ElectroIGO/bak_rl/docs/title_page.tex

\begin{titlepage}
\begin{center}
\textbf{
VENTSPILS AUGSTSKOLA\\
INFORMĀCIJAS TEHNOLOĢIJU FAKULTĀTE}\\
\vspace{1.2cm}
\textbf{BAKALAURA DARBS}\\
\vspace{1.4cm}
{\LARGE \textbf{X joslas raidīšanas sistēmas vadības bloka prototipa izstrāde}}\\
\vspace{1cm}
\begin{tabular}{@{}r@{}l@{}}
\parbox[c]{0.4\textwidth}{Autors:}&
\parbox[t]{0.6\textwidth}{
Ventspils Augstskola\\
Informācijas tehnoloģiju fakultātes\\
profesionālās bakalaura studiju programmas \\ "Elektronikas inženierija"\\
4. kursa students\\
Rodrigo Laurinovičs \\
Matrikulas~Nr. 190050 \vspace{0.7em}\\
\mbox{}\hrulefill\vspace{-0.4em}\\
{\scriptsize(paraksts)}\vspace{1.2cm}} \\
\parbox[c]{0.4\textwidth}{Fakultātes dekāns:}&
\parbox[t]{0.6\textwidth}{
doc. Dr. Sc.Comp. Vairis Caune \vspace{.7em}\\
\mbox{}\hrulefill\vspace{-0.4em}\\
{\scriptsize(paraksts)}\vspace{1.2cm}} \\
%-------------------------------------------------------------------------
\parbox[c]{0.4\textwidth}{Zinātniskais vadītājs:}&
\parbox[t]{0.6\textwidth}{
Mg. Sc. Ing. Mārcis Bleiders \vspace{.7em}\\
\mbox{}\hrulefill\vspace{-0.4em}\\
{\scriptsize(paraksts)}\vspace{1.2cm}} \\
%----------------------------------------------------------------------------------
\parbox[c]{0.4\textwidth}{Recenzents:} & %\vspace{.7em}\\
\parbox[t]{0.6\textwidth}{
Mg. Sc. Ing. Artūrs Orbidāns  \vspace{.7em}\\
%\mbox{}\hrulefill\vspace{-0.4em}\\

%{\scriptsize(Ieņemamais amats, zinātniskais nosaukums,
%vārds, uzvārds)}\vspace{2em}

\mbox{}\hrulefill\vspace{-0.4em}\\
{\scriptsize(paraksts)}\vspace{1.2em}} \\
\end{tabular}
\vfill
Ventspils, 2025
\end{center}
\end{titlepage}
