ElectroIGO/bak_rl/docs/sections/theory/power_amplifier.tex

\section{Augstas jaudas RF pastiprinātājs}
Radiofrekvences \cite{poweramplifieroverview} (RF) tīkla signālu ķēdē jaudas pastiprinātāji ieņem vietu kā pēdējais elements, sekojot tādām komponentēm kā maztrokšņojoši pastiprinātāji (LNA), jaucējiem un citām signālu apstrādes pakāpēm. Jaudas pastiprinātāji ir atbildīgi par būtisku uzdevumu – pastiprināt signālu līdz nepieciešamajam jaudas līmenim tā raidīšanai. Signāls tiek pastiprināts, lai spētu pārraidīt signālu lielos attālumos.

RF jaudas pastiprinātāji ir sastopami gandrīz visās bezvadu ierīcēs – sākot no bezvadu komunikācijas sistēmām, satelītkomunikācijām, raidīšanas iekārtām, mobilajiem tālruņiem līdz IoT ierīcēm.
