ElectroIGO/bak_rl/docs/main.tex

\documentclass[12pt,paper=a4]{report}
\usepackage[utf8]{inputenc}
\usepackage{polyglossia}
%Atkāpes pirmajām rindiņām
\usepackage{indentfirst}
%Virsrakstu noformējumam
\usepackage{titlesec}
%Attēlu importēšanai
\usepackage{graphicx}
%Vajadzēs saliktus attēlus
\usepackage{subcaption}
\usepackage{float}
%Nodefinē attālumus no malām
\usepackage[a4paper, lmargin=3.5cm,rmargin=2cm,tmargin=2cm, bmargin=2cm]{geometry}
%rotēšana
\usepackage{rotating, graphicx}
%Apjomīgām tabulām
\usepackage{longtable}
% tabulu šūnu satura centrēšanai
\usepackage{array}
\newcolumntype{P}[1]{>{\centering\arraybackslash}p{#1}}
\newcolumntype{M}[1]{>{\centering\arraybackslash}m{#1}}
%Numerācijai lappuses labajā pusē
\usepackage{fancyhdr}
%Literatūras saraksta veidošanai
%\usepackage{natbib}
\usepackage{hyperref} % For clickable links
\usepackage{url}      % For better URL formatting
\bibliographystyle{IEEEtran}

%Garas formulas
\usepackage{amsmath}

%tabulas
\usepackage{booktabs}
\usepackage{adjustbox}

% rindu sapludināšana tabulā
\usepackage{multirow}% http://ctan.org/pkg/multirow
\usepackage{hhline}% http://ctan.org/pkg/hhline
%laas tabulas
\usepackage{tabularx}
\usepackage{boldline}
%Lai varetu ievietot lapu landscape
\usepackage{lscape}
% pielikumam
\usepackage[titletoc]{appendix}
% Allows line breaks within cells
\usepackage{array}     % For column alignment
\usepackage{makecell}  % For line breaks in headers

\usepackage{pgfplots} % Required for plotting
\pgfplotsset{compat=1.18} % Ensure compatibility
\usepackage{siunitx} % For SI unit formatting

\usepackage{svg}
%Noformējuma parametri---------------------------------------------------------------------------------------------
%Nodefinējam valodas
\usepackage[labelsep=space]{caption} % Global setting for all tables
\setdefaultlanguage{latvian}
\setotherlanguages{english,russian}

%Fonts un atstarpe starp rindām
\setmainfont{Times New Roman}
%Rindiņas pirmā atkāpe
\setlength{\parindent}{1.27cm}
\usepackage{setspace}
\onehalfspacing
%Apakšmape bildēm
\graphicspath{{./pictures/}{./Schematics/}}

\renewcommand{\sfdefault}{ptm}

\titleformat{\chapter}
  {\centering\sffamily\fontsize{16}{16}\bfseries}{\thechapter \space{}}{0pc}{}
\titleformat{\section}{\sffamily\fontsize{14}{14}\bfseries}{\thesection \space{}}{0pc}{}
\titleformat{\subsection}{\sffamily\fontsize{12}{12}\bfseries}{\thesubsection \space{}}{0pc}{}
\titlespacing*{\chapter}{0pt}{0pt}{15pt} 
\titlespacing*{\section}{0pt}{20pt}{10pt} 
\titlespacing*{\subsection}{0pt}{15pt}{10pt} 

%Nodefinējam objektu numerācijas noteikumus
\def\thechapter      {\arabic{chapter}}
\def\thesection      {\ifx\chapter.\undefined{\arabic{section}}\else  {\thechapter.\arabic{section}}\fi}
\def\thesubsection   {\thesection.\arabic{subsection}}
\def\thesubsubsection{\thesubsection.\arabic{subsubsection}}

\usepackage{pdfpages}

\renewcommand{\thefigure}{\arabic{chapter}.\arabic{figure}.}
\renewcommand{\theequation}{\thechapter.\arabic{equation}.}
\renewcommand{\thetable}{\thechapter.\arabic{table}.}
%Attelu un tabulu nosaukumi
%\captionsetup[figure] {labelformat=default,labelsep=space,justification=centerlast}
%\captionsetup[table] {labelformat=simple,labelsep=newline,textfont=bf}
%\renewcommand{\figurename}{att.}

%\renewcommand{\tablename}{tabula}
%\renewcommand{\appendixname}{Pielikums}
%\makeatletter
%\renewcommand{\fnum@figure}{}
%\makeatother
%Teksta nodaļu fiksētie nosaukumi
\addto\captionslatvian{
\renewcommand\bibname{Izmantotās literatūras un avotu saraksts}
\renewcommand{\contentsname}{Saturs}
}

%Numeracija

\pagestyle{fancy}

\fancyhf{}
\renewcommand{\headrulewidth}{0pt} 
\renewcommand{\footrulewidth}{0pt}
\fancyfoot[R]{\thepage}
\fancypagestyle{plain}{%
  \fancyfoot[R]{\thepage}%
}
%Pārnesumiem - ļauj tiasīt lielākas starpas
\hyphenpenalty=5000
%% Atraitņrindiņas un bāreņrindiņas ( widow orphan) vadība
\clubpenalty10000
\widowpenalty10000
% Apakšsvītrām
\usepackage{underscore}
% pārkares paragrāfiem (speciāli saīsinājumiem)
\newenvironment{hangingpar}[1]
  {\begin{list}
          {}
          {\setlength{\itemindent}{-#1}%%'
           \setlength{\leftmargin}{#1}%%'
           \setlength{\itemsep}{0pt}%%'
           \setlength{\parsep}{\parskip}%%'
           \setlength{\topsep}{\parskip}%%'
           }
    \setlength{\parindent}{-#1}%%
    \item[]
  }
  {\end{list}}

%\renewcommand{\baselinestretch}{1.5}
\fontsize{12pt}{1.2}
\linespread{1.25} %1.2 *1.25 = 1.5

\begin{document}

% % Titullapa
\input{title_page.tex}
\pagenumbering{gobble}
%Vieta anotācijām---------------------------------------------------------------------------
\input{LV_abstract.tex}
\input{ENG_abstract.tex}
%Saturs---------------------------------------------------------------------------------------
\tableofcontents
\input{abbreviations.tex}
\clearpage
\pagenumbering{arabic}
\setcounter{page}{6}
\input{sections/ievads.tex}
\input{sections/teorija.tex}
\input{sections/izstrade.tex}
\input{sections/testesana.tex}
\input{sections/secinajumi.tex}
\bibliography{refs}
%\input{pielikumi.tex}
\includepdf[pages=-]{Galvojums.pdf}

\end{document}
