ElectroIGO/bak_rl/docs/sections/izstrade.tex

\chapter{X joslas raidīšanas sistēmas vadības bloka prototipa izstrāde}

Šajā nodaļā ir izklāstīta šī bakalaura darba ietvaros veiktā X joslas raidīšanas sistēmas vadības bloka prototipa izstrāde. Sākas nodaļa ar sistēmas pārskatu, tad tiek aprakstīts darba punkta iestatīšanas izstrādes process, kur tiek aprakstītas izveidotās iespiedplates, pēc kā tiek pievērsta uzmanība mikrokontrolierim, programmas kodam un lietojumprogrammas izstrādei, tad tiek aprakstīta jaudas monitorēšanas sistēmas izstrāde, kur beigās ir gala prototipu apraksts, kur tiek aprakstīts atsevišķo sistēmu novietojums korpusā. Visas izstrādnes, kas tika izstrādātas šī bakalaura ietvaros, tiek uzglabātas githubā\cite{bak_github}.

\input{sections/development/system_overview}
\input{sections/development/bias_system}
\input{sections/development/mcu_code}
\input{sections/development/power_system}
\input{sections/development/finished_prototype}
