ElectroIGO/bak_rl/docs/sections/teorija.tex

\chapter{Teorija}
Šajā nodaļā tiek aprakstīta VSRC X-joslas raidzutveršanas sistēma, VSRC augstas jaudas pastiprinātājs, dziļā kosmosa misiju spektra sadalījums, VSRC dotā specifikācija darba punkta iestatīšanai jaudas pastiprinātājam, ieskats RF jaudas pastiprinātāju vadības sistēmās un pieejamās integrālās shēmas, virziena nozarotāja darbības princips, jaudas detektori, diferenciālā mērīšanas metode un S-parametri.

\input{sections/theory/system_overview}
\input{sections/theory/hpa_bloks}
%\input{sections/theory/power_amplifier}
\input{sections/theory/space_bands}
\input{sections/theory/specification}
\input{sections/theory/bias_system}
\input{sections/theory/directional_coupler}
\input{sections/theory/power_detectors}
\input{sections/theory/diff_measurement}
\input{sections/theory/s-parameters}
