ElectroIGO/bak_rl/docs/pictures/9v5vlines.jpg

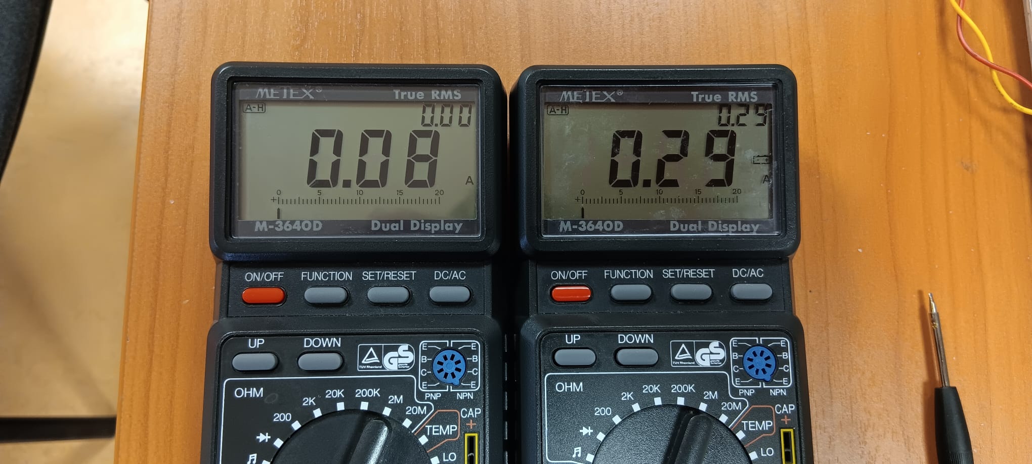
docs/pictures/9v5vlines.jpg
