ElectroIGO/bak_rl/docs/pictures/finished.jpg

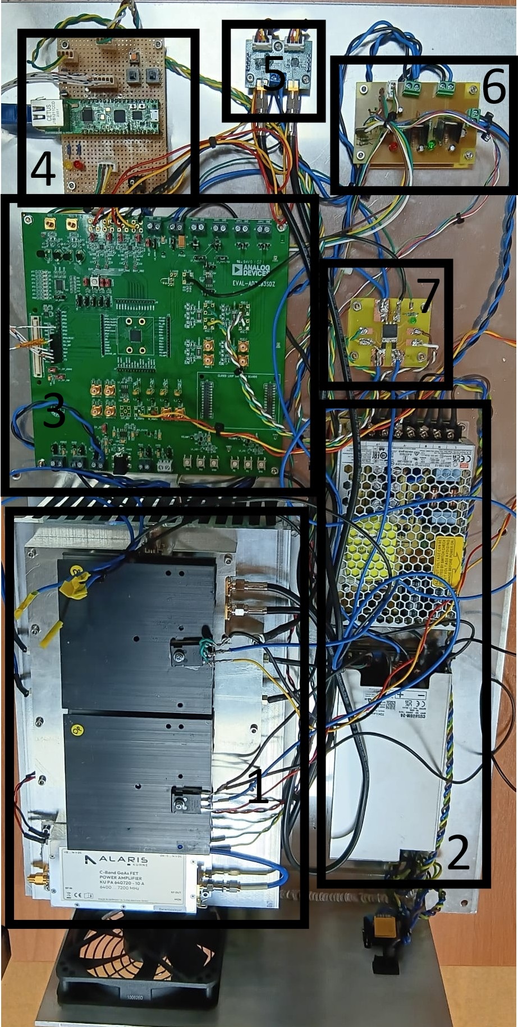
docs/pictures/finished.jpg
