ElectroIGO/bak_rl/docs/pictures/forward_coupling.png

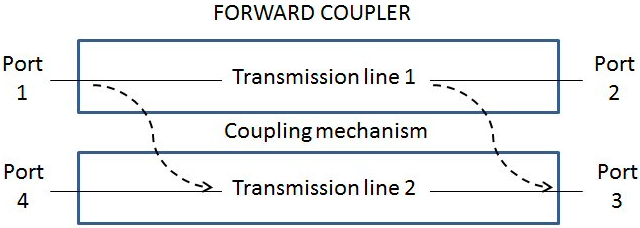
docs/pictures/forward_coupling.png
