ElectroIGO/bak_rl/docs/pictures/frequencies-and-bands-specturm.png

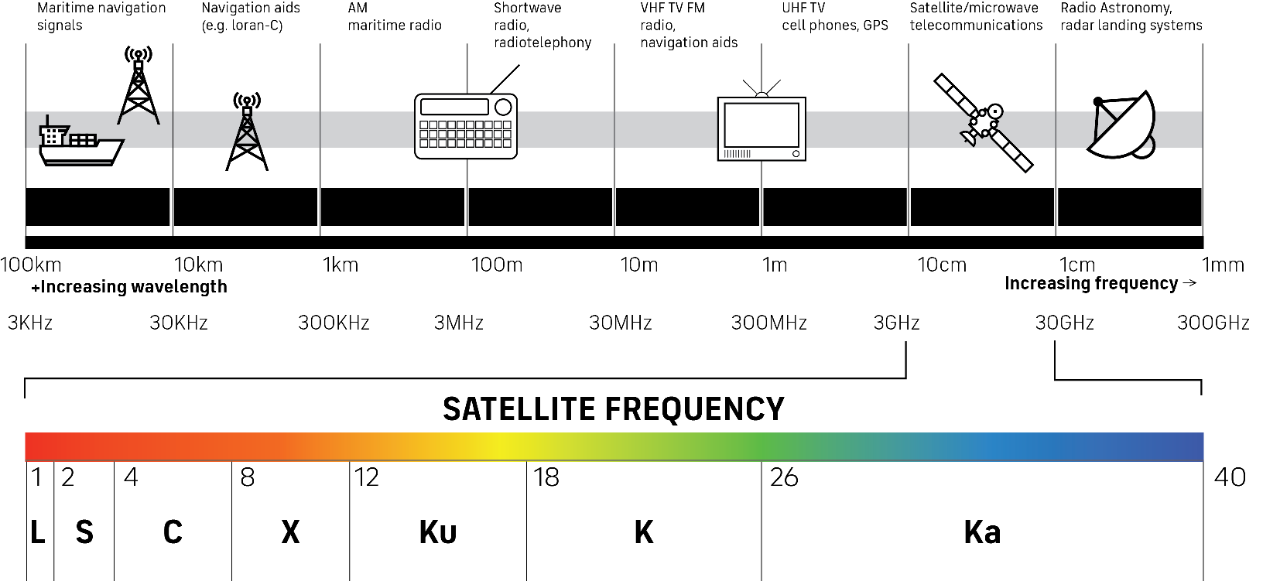
docs/pictures/frequencies-and-bands-specturm.png
