ElectroIGO/bak_rl/docs/pictures/herkules.png

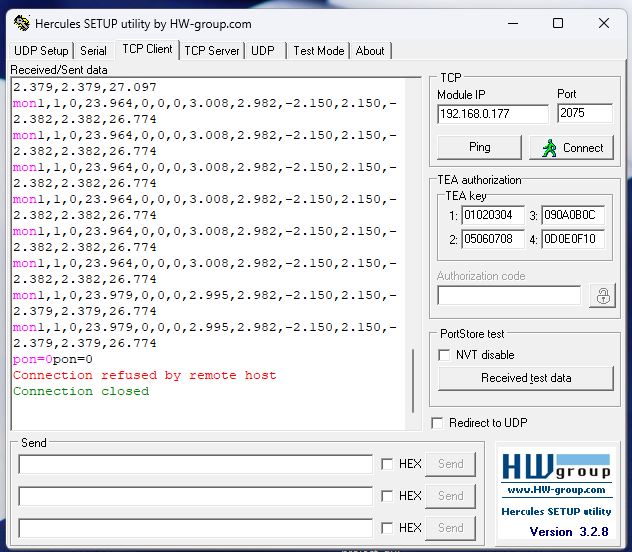
docs/pictures/herkules.png
