ElectroIGO/bak_rl/docs/pictures/input_powerdetector.png

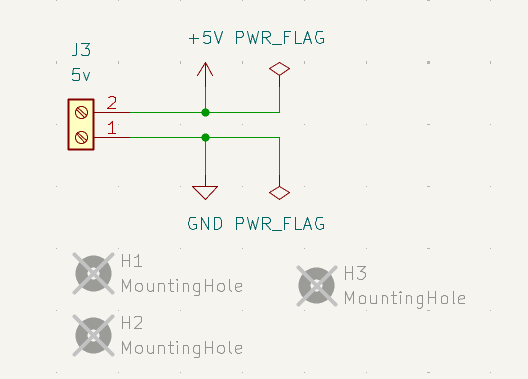
docs/pictures/input_powerdetector.png
