ElectroIGO/bak_rl/docs/pictures/inputs_mountingholes.png

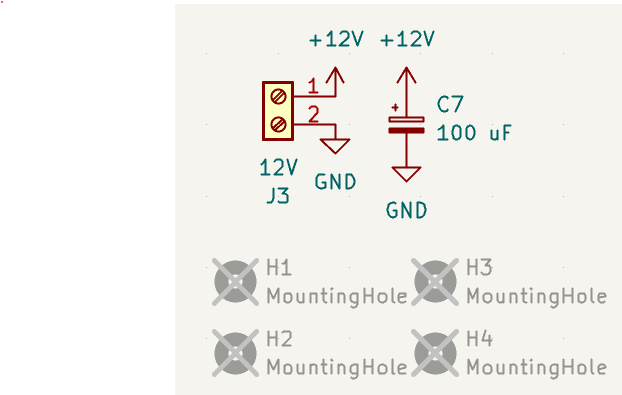
docs/pictures/inputs_mountingholes.png
