ElectroIGO/bak_rl/docs/pictures/ip_conf.png

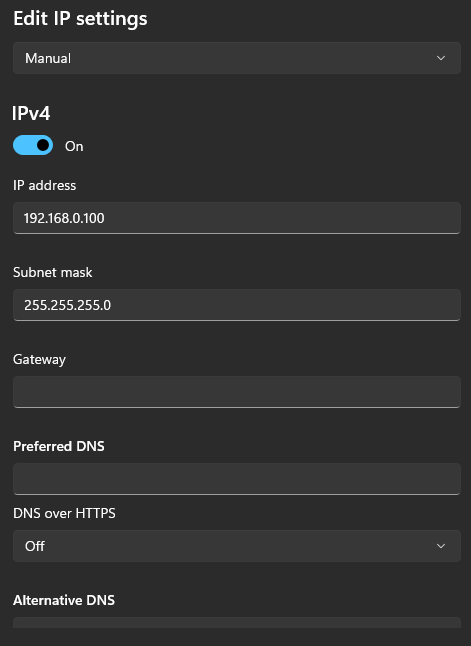
docs/pictures/ip_conf.png
