ElectroIGO/bak_rl/docs/pictures/multi-hole_coupler.png

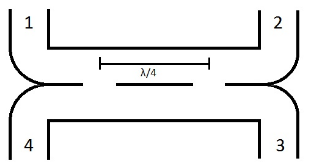
docs/pictures/multi-hole_coupler.png
