ElectroIGO/bak_rl/docs/pictures/outputs_powerdetector.png

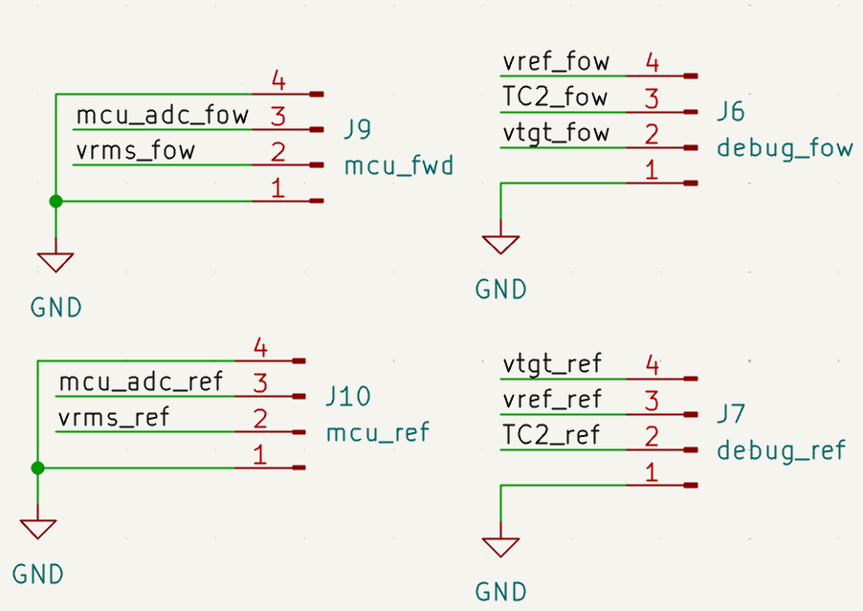
docs/pictures/outputs_powerdetector.png
