ElectroIGO/bak_rl/docs/pictures/ref_powerdetector.png

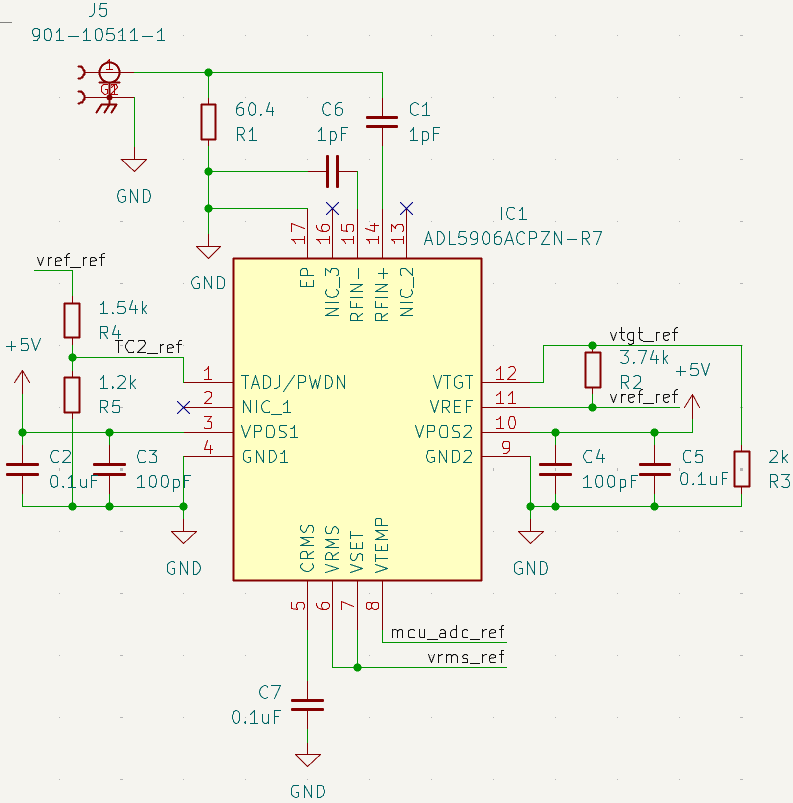
docs/pictures/ref_powerdetector.png
