ElectroIGO/bak_rl/docs/pictures/reverse_coupling.png

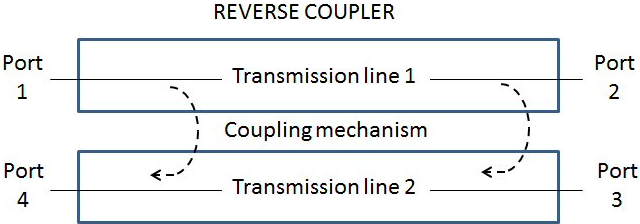
docs/pictures/reverse_coupling.png
