ElectroIGO/bak_rl/docs/pictures/script_system_start.png

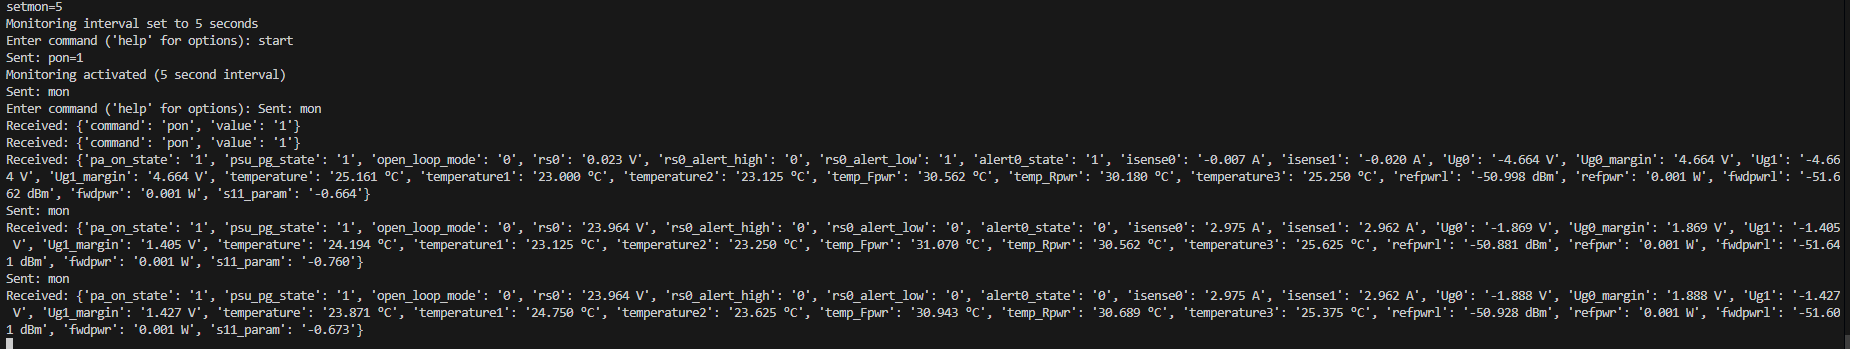
docs/pictures/script_system_start.png
