ElectroIGO/bak_rl/docs/pictures/telemetry.drawio.png

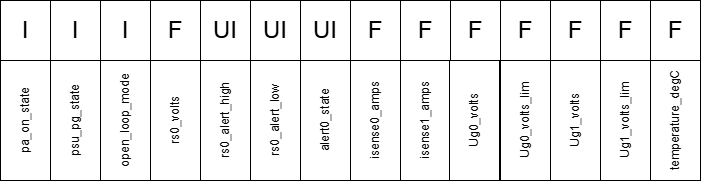
docs/pictures/telemetry.drawio.png
