ElectroIGO/bak_rl/software/blockdiagram/program.drawio.png

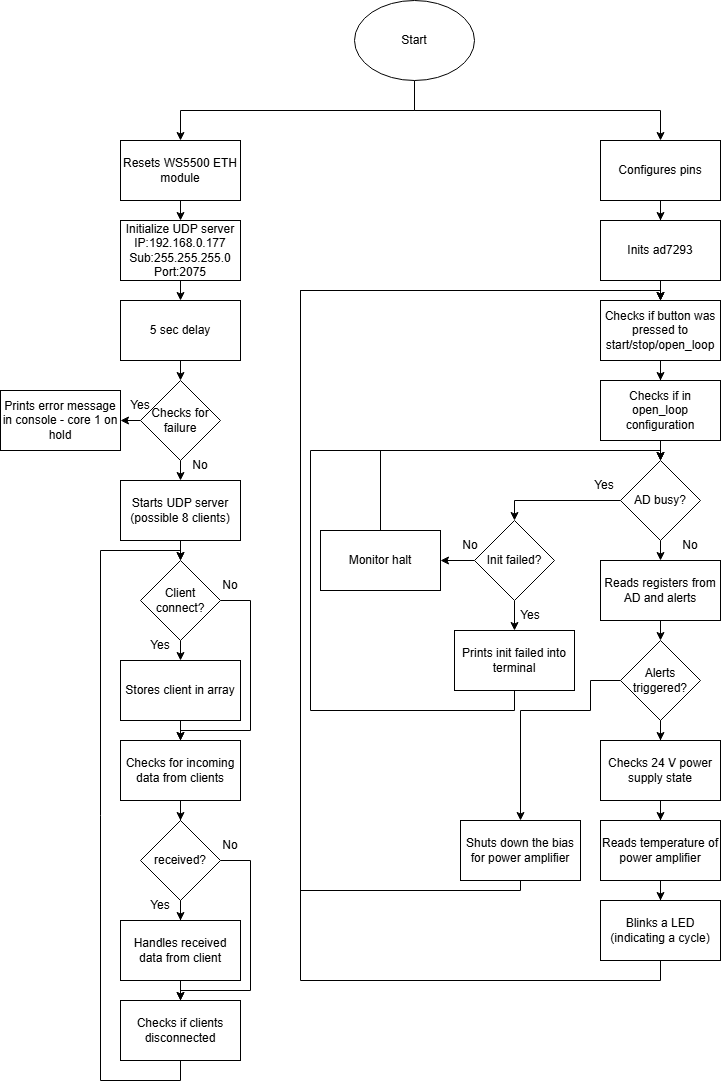
software/blockdiagram/program.drawio.png
