ElectroIGO/bak_rl/software/blockdiagram/script_program.drawio.png

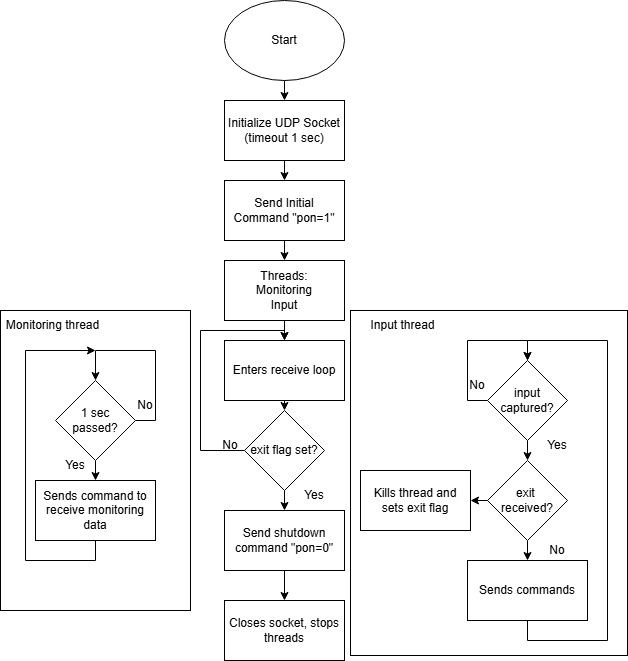
software/blockdiagram/script_program.drawio.png
