ElectroIGO/bak_rl/software/tests/power_detecter_test_mes.xlsx

REF |  |  | m=dBm/V | b=offset | diap | FWD |  |  | m=dBm/V | b=offset | diap
dbm | V |  | -41.61186331 | -41.10295293 |  | dbm | V |  | -35.22925764 | -54.06239083
-56 | 0.358 |  |  |  |  | -56 | 0.055
-53.92 | 0.361 |  |  |  |  | -53.92 | 0.055
-52.2 | 0.364 | 1 | 159.5495495 | -113.1187387 | -56; -38.29 | -52.2 | 0.055 | 1 | 42.10810811 | -58.31594595 | -56 to -48.21
-50.1 | 0.369 | 2 | 31.55256724 | -52.25404645 | -38.29; -12.48 | -50.1 | 0.06 | 2 | 45.81395349 | -60.23488372 | -48.21 to -38.29
-48.21 | 0.376 | 3 | 34.58181818 | -53.51290909 | -12.48; 8.54 | -48.21 | 0.24 | 3 | 46.09756098 | -61.33317073 | -38.29 to -12.48
-46.23 | 0.388 |  |  |  |  | -46.23 | 0.287 | 4 | -4.055241682 | -29.73625863 | -12.48 to 8.54
-44.23 | 0.403 |  |  |  |  | -44.23 | 0.327
-42.28 | 0.421 |  |  |  |  | -42.28 | 0.37
-40.32 | 0.443 |  |  |  |  | -40.32 | 0.416
-38.29 | 0.469 |  |  |  |  | -38.29 | 0.463
-36.32 | 0.505 |  |  |  |  | -36.32 | 0.522
-34.32 | 0.555 |  |  |  |  | -34.32 | 0.586
-32.36 | 0.61 |  |  |  |  | -32.36 | 0.647
-30.46 | 0.665 |  |  |  |  | -30.46 | 0.721
-28.59 | 0.732 |  |  |  |  | -28.59 | 0.787
-26.74 | 0.792 |  |  |  |  | -26.74 | 0.853
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
