ElectroIGO/bak_rl/docs/pictures/test_diagram1.png

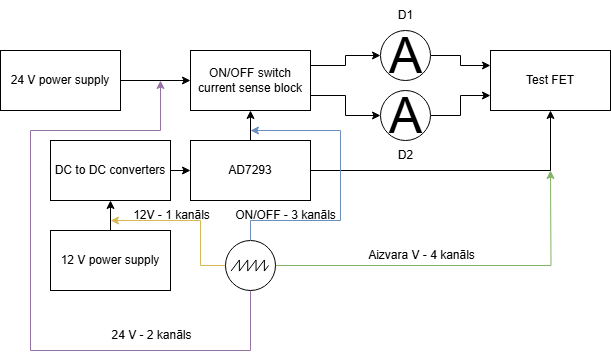
docs/pictures/test_diagram1.png
