ElectroIGO/bak_rl/docs/pictures/testa_stends.jpg

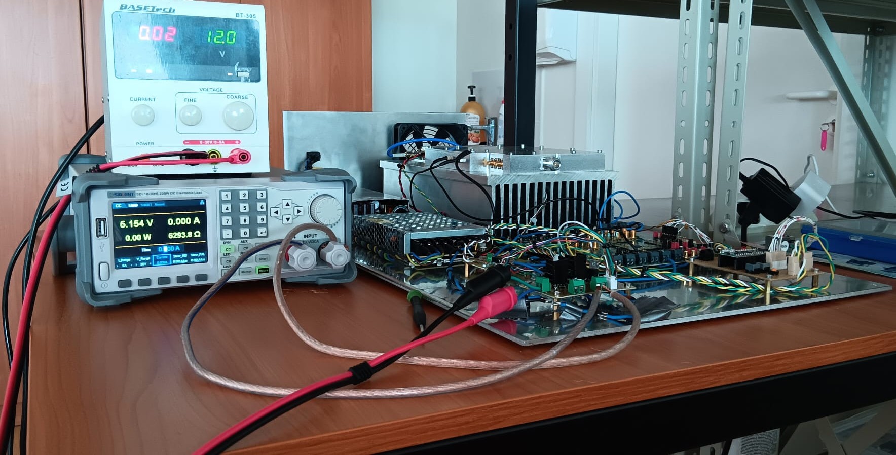
docs/pictures/testa_stends.jpg
