ElectroIGO/bak_rl/(commit log)

2025-05-06 unfinished v0.5
    [elektro_bar.kicad_pcb, elektro_bar.kicad_sch, power_detector.kicad_sch]
2025-05-29 version 1.0
    [DC_converter.kicad_sch, telemetry.xlsx, test_diagrams.kicad_pcb, test_diagrams.kicad_sch, untitled.kicad_sch, untitled10.kicad_sch, untitled2.kicad_sch, untitledsss.kicad_sch]
2025-06-10 improved accuracy of power detectors, by splitting it into more than one linear junction
2025-06-11 presentation and power detector scripts
    [power_detecter_test_mes.xlsx]
